ludgerknorps/kimubo/src/kimubo/kimubo.h

/*
   KIMUBO
   KInderMUsikBOx

   Ein minimalistischer WAV/PCM Spieler für Kinder - und mehr.

   (c) 2019 ludgerknorps <56650955+ludgerknorps@users.noreply.github.com>

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
*/
/*






   List of used ressources:

  		#######################################
  			https://github.com/hnauen/Fritzing/blob/master/GF1002_StereoAmplifier/GF1002_StereoAmplifier.fzpz
  			Fritzing part for PAM8403 Amp
  			creative commons license 4.0: Attribution-ShareAlike CC BY-SA
  		#######################################



*/

#ifndef KIMUBO_H
#define KIMUBO_H



#include <Arduino.h>

// Power saving techniques
#include <avr/power.h>
#include <avr/sleep.h>





// ####################################################################################
// ####################################################################################
// ####################################################################################
// ####################################################################################
// ####################################################################################
// ####################################################################################
// ####################################################################################
// ####################################################################################
// ####################################################################################
/*
   Abschnitt DEBUG
*/

// defining debug --> serial output delivers information on internals, timing and cpu load may be a little of compared to non-debug-mode
//	#define debug


// ####################################################################################
// ####################################################################################
// ####################################################################################
// ####################################################################################
// ####################################################################################
// ####################################################################################
// ####################################################################################
// ####################################################################################
// ####################################################################################
/*
   Abschnitt MESSAGES
*/
// define messages as byte arrays in progmem
// see kimubo_090_messages.ino for description

const byte message_readAll[] PROGMEM = { 0, 1, 2, 3, 4, 5, 6, 7, 8, 9, 10, 11 };
const byte message_greeting[] PROGMEM = { 254 };


const byte message_loudness_off[] PROGMEM = { 20 };
const byte message_loudness_on[]  PROGMEM = { 21 };
const byte message_greeting_off[] PROGMEM = { 22 };
const byte message_greeting_on[]  PROGMEM = { 23 };
const byte message_autoplay_off[] PROGMEM = { 24 };
const byte message_autoplay_on[]  PROGMEM = { 25 };


// ####################################################################################
// ####################################################################################
// ####################################################################################
// ####################################################################################
// ####################################################################################
// ####################################################################################
// ####################################################################################
// ####################################################################################
// ####################################################################################
/*
  Abschnitt Main
*/

// tbd later!
//~ // for seeking, i.e. fast forward or backward in a track
//~ //        In order to do that we play a short part of the track,
//~ //        then hop to a position a little further, play again, hop again, etc.
//~ //        There are two relevant user-defined constants:
//~ //          a) SEEK_SPEEDUP       how fast shall seeking be (in times of normal play speed)
//~ //          b) SEEK_DURATION_PLAYING  how much of a track shall be played between hops (in milliseconds)
//~ #define SEEK_SPEEDUP      10
//~ #define SEEK_DURATION_PLAYING 10
//~ //        From those user-defined constants we can derive some internally relevant auto-constants:
//~ //          c) SEEK_INTERVAL_LENGTH   how long is a one seek interval in total (playing + hopping)
//~ //          d) SEEK_INTERVAL_HOP_FWD  how far do we hop forward before playing again
//~ //          e) SEEK_INTERVAL_HOP_BWD  how far do we hop backward before playing again
//~ #define SEEK_INTERVAL_LENGTH  (1000/SEEK_SPEEDUP)
//~ #define SEEK_INTERVAL_HOP_FWD (SEEK_INTERVAL_LENGTH-SEEK_DURATION_PLAYING)
//~ #define SEEK_INTERVAL_HOP_BWD (SEEK_INTERVAL_LENGTH+SEEK_DURATION_PLAYING)

// tbd later!
//~ // for powersaving there is one relevant user-defined constant:
//~ //          a) POWERSAVE_AFTER      after which time (in milliseconds) shall device enter low-power-state
//~ //                        coming from idle, the low-power-state is recoverable,
//~ //                        i.e. we can return to idle on e.g. keypress
//~ #define POWERSAVE_AFTER     3000000
//~ //        From this user-defined constant we can derive some internally relevant auto-constants:
//~ //          b) POWERSAVE_AFTER_PAUSE  after which time in pause-state shall device enter low-power-state
//~ //                        (in times of POWERSAVE_AFTER, not milliseconds!)
//~ //                        coming from pause, the low-power-state is recoverable,
//~ //                        i.e. we can return to pause on e.g. keypress BUT NOT by just turning
//~ //                        the volume up again, thus do not choose a too small value here!
//~ #define POWERSAVE_AFTER_PAUSE (60*POWERSAVE_AFTER)



// if playing stopped, go to powersave mode after configurable time, iff no new track/playlist selected
// in milliseconds
// default is 30minutes aka 900000L
#define POWERSAVE_IF_STOP_AFTER		900000L

// ####################################################################################
// ####################################################################################
// ####################################################################################
// ####################################################################################
// ####################################################################################
// ####################################################################################
// ####################################################################################
// ####################################################################################
// ####################################################################################
/*
  Abschnitt UBat
*/

// the voltage where kimubo shall not startup and shall automatically shut down.
// - in future TBD! - we differentiate between batteries and accumulators.
// for that we will introduce a switch/jumper/... in the back of the KIMUBO - only to be set by parents.
// batteries shall be discharged as much as possible, i.e. down to 0V (ideally)
// accus shall be only discharged down to their limit of about 1000mV in order to increase their life expectancy
// all voltages are given in mV!
#define UBAT_ABSOLUTE_MINIMUM_VOLTAGE_BAT		0
#define UBAT_ABSOLUTE_MINIMUM_VOLTAGE_ACCU		4000







// ####################################################################################
// ####################################################################################
// ####################################################################################
// ####################################################################################
// ####################################################################################
// ####################################################################################
// ####################################################################################
// ####################################################################################
// ####################################################################################
/*
   Abschnitt PCM player
*/

// ++++++++++++++++++++++++++++++++++++++++++++++++++++++++++++++++++++++++++++++++++++
// ++++++++++++++++++++++++++++++++++++++++++++++++++++++++++++++++++++++++++++++++++++
// ++++++++++++++++++++++++++++++++++++++++++++++++++++++++++++++++++++++++++++++++++++
// Pins
// pins are Arduino pin nr.
#define AUDIO_PIN_OUT_HIGH		9
#define AUDIO_PIN_OUT_LOW		10

#define AUDIO_PIN_LOUDNESS  	2


// ####################################################################################
// ####################################################################################
// ####################################################################################
// ####################################################################################
// ####################################################################################
// ####################################################################################
// ####################################################################################
// ####################################################################################
// ####################################################################################
/*
   Abschnitt EEPROM
*/



/* EEPROM Data Layout:
    EEPROM_BASE_ADDR
   	+ 0 Bytes = four Byte (type long) for a chip specific compensation value for accurate VCC measurements

   	+ 4 Bytes = one Byte type byte with ragng (1 ..9) for the last playlist that was played

  		+ 1 Bytes = one Byte type byte for the last track that was played in playlist 1
 		+ 1 Bytes = one Byte type byte for the last track that was played in playlist 2
  		+ 1 Bytes = one Byte type byte for the last track that was played in playlist 3
  		+ 1 Bytes = one Byte type byte for the last track that was played in playlist 4
 		+ 1 Bytes = one Byte type byte for the last track that was played in playlist 5
  		+ 1 Bytes = one Byte type byte for the last track that was played in playlist 6
  		+ 1 Bytes = one Byte type byte for the last track that was played in playlist 7
 		+ 1 Bytes = one Byte type byte for the last track that was played in playlist 8
  		+ 1 Bytes = one Byte type byte for the last track that was played in playlist 9

  		+ 1 Bytes = four Bytes type unsigned long for the last position in last track that was played in playlist 1
 		+ 4 Bytes = four Bytes type unsigned long for the last position in last track that was played in playlist 2
  		+ 4 Bytes = four Bytes type unsigned long for the last position in last track that was played in playlist 3
  		+ 4 Bytes = four Bytes type unsigned long for the last position in last track that was played in playlist 4
 		+ 4 Bytes = four Bytes type unsigned long for the last position in last track that was played in playlist 5
  		+ 4 Bytes = four Bytes type unsigned long for the last position in last track that was played in playlist 6
  		+ 4 Bytes = four Bytes type unsigned long for the last position in last track that was played in playlist 7
 		+ 4 Bytes = four Bytes type unsigned long for the last position in last track that was played in playlist 8
  		+ 4 Bytes = four Bytes type unsigned long for the last position in last track that was played in playlist 9

  		in sum : 50 byte
*/
static const byte EEPROM_BASE_ADDR      		= 	0	; // this one should not be used directly in code, instead use specific addresses form below
// can be set to any value between 0 and "real_eeprom_size" - all bytes used (currently 50)
// therefore for ATMEGA328P with 1024byte EEPROM: between 0 .. 973
// BEWARE:
// we have 1024 bytes of EEPROM on the ATmega328P --> addresses in EEPROM need to be of type "short",
// if we need to address whole EEPROM space.
// As we only need a subset of the address-space we can use byte type instead for addresses,
// iff (!) we limit base address + max needed space (= upper limit of used space)
// to bee 255 or less.

// At first we do not use any wear leveling as the estimated 100000 cycles of EEPROM life amount to
// approx. 100000/10/365 ~= 27 years of use with ten uses per day each day of the year...

static const byte EEPROM_VCCCOMPENSATION_ADDR	=	EEPROM_BASE_ADDR + 0; // four bytes used

static const byte EEPROM_PARENTADMINMODE_SETTINGS_ADDR	= EEPROM_VCCCOMPENSATION_ADDR + 4	; // one byte used

static const byte EEPROM_LAST_PLAYLIST_ADDR		=	EEPROM_PARENTADMINMODE_SETTINGS_ADDR + 1	; // one byte used

// tbd later!
static const byte EEPROM_LAST_TRACK_IN_PLAYLIST[9] = {	EEPROM_LAST_PLAYLIST_ADDR + 1,
                                                        EEPROM_LAST_PLAYLIST_ADDR + 2,
                                                        EEPROM_LAST_PLAYLIST_ADDR + 3,
                                                        EEPROM_LAST_PLAYLIST_ADDR + 4,
                                                        EEPROM_LAST_PLAYLIST_ADDR + 5,
                                                        EEPROM_LAST_PLAYLIST_ADDR + 6,
                                                        EEPROM_LAST_PLAYLIST_ADDR + 7,
                                                        EEPROM_LAST_PLAYLIST_ADDR + 8,
                                                        EEPROM_LAST_PLAYLIST_ADDR + 9
                                                     }; // two bytes used, each

// tbd later!
//~ static const byte EEPROM_LAST_POSITION_IN_TRACK_IN_PLAYLIST[9] = {	EEPROM_LAST_TRACK_IN_PLAYLIST[8] + 1,
//~ EEPROM_LAST_TRACK_IN_PLAYLIST[8] + 6,
//~ EEPROM_LAST_TRACK_IN_PLAYLIST[8] + 10,
//~ EEPROM_LAST_TRACK_IN_PLAYLIST[8] + 14,
//~ EEPROM_LAST_TRACK_IN_PLAYLIST[8] + 18,
//~ EEPROM_LAST_TRACK_IN_PLAYLIST[8] + 22,
//~ EEPROM_LAST_TRACK_IN_PLAYLIST[8] + 26,
//~ EEPROM_LAST_TRACK_IN_PLAYLIST[8] + 30,
//~ EEPROM_LAST_TRACK_IN_PLAYLIST[8] + 34}; // four bytes used, each


// ####################################################################################
// ####################################################################################
// ####################################################################################
// ####################################################################################
// ####################################################################################
// ####################################################################################
// ####################################################################################
// ####################################################################################
// ####################################################################################
/*
   Abschnitt MatrixKeyboard
*/

// ++++++++++++++++++++++++++++++++++++++++++++++++++++++++++++++++++++++++++++++++++++
// ++++++++++++++++++++++++++++++++++++++++++++++++++++++++++++++++++++++++++++++++++++
// ++++++++++++++++++++++++++++++++++++++++++++++++++++++++++++++++++++++++++++++++++++
// 1. Definition KeyScanCodes
static const char KEYSCAN_1      =  '0' ;
static const char KEYSCAN_2      =  '1' ;
static const char KEYSCAN_3      =  '2' ;
static const char KEYSCAN_4      =  '3' ;
static const char KEYSCAN_5      =  '4' ;
static const char KEYSCAN_6      =  '5' ;
static const char KEYSCAN_7      =  '6' ;
static const char KEYSCAN_8      =  '7' ;
static const char KEYSCAN_9      =  '8' ;
static const char KEYSCAN_FFWD   =  'F' ;  // FastForwar / Skip
static const char KEYSCAN_REW    =  'R' ;  // Rewind / Skipback
static const char KEYSCAN_A    	 =  'A' ;  // reserved for future use

// ++++++++++++++++++++++++++++++++++++++++++++++++++++++++++++++++++++++++++++++++++++
// ++++++++++++++++++++++++++++++++++++++++++++++++++++++++++++++++++++++++++++++++++++
// ++++++++++++++++++++++++++++++++++++++++++++++++++++++++++++++++++++++++++++++++++++
// 2. Aus wievielen Reihen und Spalten ist Matrix des Keyboards aufgebaut?

// real hardware no. of rows/colums
static const byte KEYB_ROWS = 4;
static const byte KEYB_COLS = 3;

// ++++++++++++++++++++++++++++++++++++++++++++++++++++++++++++++++++++++++++++++++++++
// ++++++++++++++++++++++++++++++++++++++++++++++++++++++++++++++++++++++++++++++++++++
// ++++++++++++++++++++++++++++++++++++++++++++++++++++++++++++++++++++++++++++++++++++
// 3. Which pin has which matrix-keyboard-row/-column?

// pins are Arduino pin nr.
static const byte KEYB_PIN_COLUMN1  = 7;
static const byte KEYB_PIN_COLUMN2  = 8;
static const byte KEYB_PIN_COLUMN3  = A1;
static const byte KEYB_PIN_ROW1   = 6;  // used as digital pin
static const byte KEYB_PIN_ROW2   = 5;    // used as digital pin
static const byte KEYB_PIN_ROW3   = A2;    // used as digital pin
static const byte KEYB_PIN_ROW4   = A3;    // used as digital pin

// ++++++++++++++++++++++++++++++++++++++++++++++++++++++++++++++++++++++++++++++++++++
// ++++++++++++++++++++++++++++++++++++++++++++++++++++++++++++++++++++++++++++++++++++
// ++++++++++++++++++++++++++++++++++++++++++++++++++++++++++++++++++++++++++++++++++++
// 4. Which Pins are rows, which are columns

// für Power Down müssen alle Reihen-Pins auf High gesezt werden (und danach wieder auf Low)
// dazu müssen wir festlagen, welches die Reihen-Pins und welches die Spalten-Pins sind
static const byte KEYB_RowPins[KEYB_ROWS] = {
  KEYB_PIN_ROW1,
  KEYB_PIN_ROW2,
  KEYB_PIN_ROW3,
  KEYB_PIN_ROW4
}; //connect to the row pinouts of the keypad

static const byte KEYB_ColPins[KEYB_COLS] = {
  KEYB_PIN_COLUMN1,
  KEYB_PIN_COLUMN2,
  KEYB_PIN_COLUMN3
}; //connect to the column pinouts of the keypad


// ++++++++++++++++++++++++++++++++++++++++++++++++++++++++++++++++++++++++++++++++++++
// ++++++++++++++++++++++++++++++++++++++++++++++++++++++++++++++++++++++++++++++++++++
// ++++++++++++++++++++++++++++++++++++++++++++++++++++++++++++++++++++++++++++++++++++
// 5. damit µC zwischendurch in Powerdown gehen kann, müssen alle Keyboard-Inputs (=Reihen, s.o.) mit je einer Diode an diesen Interrupt-Pin angeschlossen sein; dieser weckt dann den µC auf)
// tbd later! static const byte KEYB_PIN_INTERRUPT = 2;

// ++++++++++++++++++++++++++++++++++++++++++++++++++++++++++++++++++++++++++++++++++++
// ++++++++++++++++++++++++++++++++++++++++++++++++++++++++++++++++++++++++++++++++++++
// ++++++++++++++++++++++++++++++++++++++++++++++++++++++++++++++++++++++++++++++++++++
// 6. Die TastaturBelegung selbst = welche Taste ist wo?

static const char KEYB_keyScans[KEYB_ROWS][KEYB_COLS] = {
  { KEYSCAN_1,    KEYSCAN_2,    KEYSCAN_3 },
  { KEYSCAN_4,    KEYSCAN_5,    KEYSCAN_6 },
  { KEYSCAN_7,    KEYSCAN_8,    KEYSCAN_9 },
  { KEYSCAN_REW,  KEYSCAN_FFWD, KEYSCAN_A }
};

// ++++++++++++++++++++++++++++++++++++++++++++++++++++++++++++++++++++++++++++++++++++
// ++++++++++++++++++++++++++++++++++++++++++++++++++++++++++++++++++++++++++++++++++++
// ++++++++++++++++++++++++++++++++++++++++++++++++++++++++++++++++++++++++++++++++++++
// 7. keypad settings

//Set the amount of milliseconds the user will have to hold a button until the HOLD state is triggered. (default = 500)
#define KEYB_HOLD_TIME  500
//Set the amount of milliseconds the keypad will wait until it accepts a new keypress/keyEvent. This is the "time delay" debounce method.  (default = 10)
#define KEYB_DEBOUNCE_TIME  10

// ####################################################################################
// ####################################################################################
// ####################################################################################
// ####################################################################################
// ####################################################################################
// ####################################################################################
// ####################################################################################
// ####################################################################################
// ####################################################################################
/*
   Abschnitt AMP(lifier)
*/

// ++++++++++++++++++++++++++++++++++++++++++++++++++++++++++++++++++++++++++++++++++++
// ++++++++++++++++++++++++++++++++++++++++++++++++++++++++++++++++++++++++++++++++++++
// ++++++++++++++++++++++++++++++++++++++++++++++++++++++++++++++++++++++++++++++++++++
// Pins
// pins are Arduino pin nr.
//~ #define AMP_PIN_LEFTIN 						0 // via resistor-ladder to both PWM outputs #9 and #10 (AUDIO_PIN_OUT_HIGH and AUDIO_PIN_OUT_LOW)
//~ #define AMP_PIN_RIGHTIN 					0 // not used
//~ #define AMP_PIN_GNDIN 						0 // directly connected to GND
//~ #define AMP_PIN_LEFTOUTPLUS 				0 // directly connected to SPEAKER_PIN_PLUS
//~ #define AMP_PIN_LEFTOUTGND 					0 // directly connected to SPEAKER_PIN_MINUS
//~ #define AMP_PIN_RIGHTOUTPLUS 				0 // not used
//~ #define AMP_PIN_LEFTOUTGND 					0 // not used
//~ #define AMP_PIN_POWERPLUS 					0 // directly connected to BATTERY_PIN_PLUS
//~ #define AMP_PIN_POWERGND 					0 // directly connected to GND and BATTERY_PIN_GND
//~ #define AMP_PIN_SWITCHED_PLUS 				0 // directly connected to RAW // this is our power supply!
// used as analog input pin:
// tbd later! #define AMP_PIN_VOL_FEEDBACK					A6
// used as digital output pins:
// tbd later! #define AMP_PIN_MUTE	 						    3

#define AMP_PIN_SUSPEND							  4


// ####################################################################################
// ####################################################################################
// ####################################################################################
// ####################################################################################
// ####################################################################################
// ####################################################################################
// ####################################################################################
// ####################################################################################
// ####################################################################################
/*
   Abschnitt SDCard
*/



// ++++++++++++++++++++++++++++++++++++++++++++++++++++++++++++++++++++++++++++++++++++
// ++++++++++++++++++++++++++++++++++++++++++++++++++++++++++++++++++++++++++++++++++++
// ++++++++++++++++++++++++++++++++++++++++++++++++++++++++++++++++++++++++++++++++++++
// Pins
// pins are Arduino pin nr.
#define SDC_PIN_MOSI	 			11
#define SDC_PIN_MISO				12
#define SDC_PIN_SCK					13
#define SDC_PIN_CS					A0
#define SD_ChipSelectPin A0
//~ #define SDC_PIN_VCC		 		0 // directly connected to RAW
//~ #define SDC_PIN_GND	 			0 // directly connected to GND

// ++++++++++++++++++++++++++++++++++++++++++++++++++++++++++++++++++++++++++++++++++++
// ++++++++++++++++++++++++++++++++++++++++++++++++++++++++++++++++++++++++++++++++++++
// ++++++++++++++++++++++++++++++++++++++++++++++++++++++++++++++++++++++++++++++++++++
// Globals

// define what suffix all PCM/WAV files need to have on the SD-card.
// relevant for "normal" PCM files as well as message-files.
const char SUFFIX_PCM_FILES[5] = ".WAV";

// where on SDcard are all our files stored?
// we use hard-fixed "/", no user-definable variable!

// define how the subdir is named, that holds system-message-pcm-files
// relevant for "normal" PCM files as well as message-files.
// must have leading and trailing '/'
const char SDC_SYSTEM_MESSAGES_DIR[4] = "/M/";

#endif // KIMUBO_H definition
