ludgerknorps/kimubo/src/kimubo/kimubo_020_pcmplayer.ino

/* 
 * KIMUBO
 * KInderMUsikBOx
 * 
 * Ein minimalistischer WAV/PCM Spieler für Kinder - und mehr.
 * 
 * (c) 2019 ludgerknorps <56650955+ludgerknorps@users.noreply.github.com>
 * 
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
 */

//
bool player_setup(){

    player.setupPlayer(AUDIO_PIN_OUT_HIGH, AUDIO_PIN_OUT_LOW);

	// not necessary with change to loudness setting via parent admin mode!
    //pinMode(AUDIO_PIN_LOUDNESS,INPUT_PULLUP);
    //player_is_loudness = true; // default as lkpcm player also starts with volume = 0 (which is loudness), the non-loudness volume would be -3

	if ( readParentAdminSettingLoudness() ) {
		setLoudness();
	} else {
		unsetLoudness();
	}
    
    #if defined (debug)
        Serial.print(F("kimubo INFO software volume is "));
        Serial.println(byte(lkpcm_volume));   
    #endif

    return true; // nothing to do here yet
}

 // ####################################################################################
 // calculates the new track's filename
    void get_new_track_player_filename(const byte curFileNameAsByte, const char curPlaylistName, char* trackFilename){
       char temp_filename[4];
      
       if ( curFileNameAsByte == 255 ){
            strcpy(trackFilename, " "); // default
       } else {
            strcpy(trackFilename, "/ /");
            trackFilename[1] = curPlaylistName; // overwrite
            itoa(curFileNameAsByte, temp_filename, 10); // 10 = convert using decimal system
            strcat(trackFilename, temp_filename);
            strcat(trackFilename, SUFFIX_PCM_FILES);

       }
    } // get_new_track_player_filename()



 

/* =========================================================== */
    void trans_B1_play_playlist_from_first_track(){
        #if defined (debug)
          Serial.print(F("trans_B1_play_playlist_from_first_track "));
          Serial.println(keyb_current_playListKey);   
        #endif

        // goto right dir on sdc
        // open first file e.g. "0.WAV"
        // start playing at begin of file 0

        if ( player_track_number_min[keyb_current_playListKey - '0'] != 255) {
            // there are files in this dir
            
            // remember current playlist
            player_current_playlist_dirname = keyb_current_playListKey;

            // begin with first track 
            player_current_track = player_track_number_min[player_current_playlist_dirname - '0'];
            get_new_track_player_filename(player_current_track, player_current_playlist_dirname, player_current_track_filename);
            player.play(player_current_track_filename);

            // as we just started playback, now is a very good time to spend some CPU-cycles on remembering this track in EEPROM
            remember_current_playlist_and_track_in_eeprom(player_current_track, player_current_playlist_dirname);

            // also: check for battery voltage
            checkBatteryVoltageAndShutdownIfNeccessary();
            
        } else {
            // no file in dir --> do nothing, and just for good measurement: stop player (it should be stopped already!)
            player.stopPlayback();  
            #if defined (debug)
                Serial.print(F("kimubo INFO a playlist without files was selected "));
                Serial.println(player_current_playlist_dirname);   
            #endif
        }; 
        
    }

/* =========================================================== */
    void trans_B2_play_next_track_in_playlist(){

        if ( lkpcm_isStopped ) {
            return; // do nothing, if player is not playing...
        } else{
            player.stopPlayback();
        }
        
        #if defined (debug)
          Serial.print(F("trans_B2_play_next_track_in_playlist "));
          Serial.println(player_current_track);
        #endif

        if ( player_current_track == player_track_number_max[player_current_playlist_dirname - '0'] ) {
            // we had already readched last track 
            #if defined (debug)
                Serial.print(F("kimubo INFO autostop at end of playlist "));
                Serial.println(player_current_track_filename);   
            #endif 
            player.stopPlayback(); 

            // also: check for battery voltage
            checkBatteryVoltageAndShutdownIfNeccessary();
            
            return;
           
        } else {
            player_current_track++;
            get_new_track_player_filename(player_current_track, player_current_playlist_dirname, player_current_track_filename);

            #if defined (debug)
                Serial.print(F("kimubo INFO playing next track "));
                Serial.println(player_current_track_filename);   
            #endif

            player.play(player_current_track_filename);
            
            // as we just started playback, now is a very good time to spend some CPU-cycles on remembering this track in EEPROM
            remember_current_playlist_and_track_in_eeprom(player_current_track, player_current_playlist_dirname);

            // also: check for battery voltage
            checkBatteryVoltageAndShutdownIfNeccessary();
            
            return;
        }
   } // trans_B2_play_next_track_in_playlist


/* =========================================================== */
    void trans_E1_skip_forward(){

        if ( lkpcm_isStopped ) {
            return; // do nothing, if player is not playing...
        }
        
        #if defined (debug)
          Serial.print(F("trans_E1_skip_forward "));  
          Serial.println(player_current_track);
        #endif

        if ( player_current_track == player_track_number_max[player_current_playlist_dirname - '0'] ) {
            // we had already readched last track 
            // as we are skipping on command of user, do nothing, there is no next file 
            #if defined (debug)
                Serial.print(F("kimubo INFO cannot skip to next track, last track reached "));
                Serial.println(player_current_track_filename);   
            #endif 
            return;
           
        } else {
            player_current_track++;
            get_new_track_player_filename(player_current_track, player_current_playlist_dirname, player_current_track_filename);

            #if defined (debug)
                Serial.print(F("kimubo INFO skipping to next track "));
                Serial.println(player_current_track_filename);   
            #endif

            player.play(player_current_track_filename);

            // as we just started playback, now is a very good time to spend some CPU-cycles on remembering this track in EEPROM
            remember_current_playlist_and_track_in_eeprom(player_current_track, player_current_playlist_dirname);

            // also: check for battery voltage
            checkBatteryVoltageAndShutdownIfNeccessary();
            
            return;
        }
   } // trans_E1_skip_forward


/* =========================================================== */
    void trans_E2_skip_backward(){

        if ( lkpcm_isStopped ) {
            return; // do nothing, if player is not playing...
        }
        
        #if defined (debug)
          Serial.print(F("trans_E2_skip_backward ")); 
          Serial.println(player_current_track);
        #endif

        if ( player_current_track == player_track_number_min[player_current_playlist_dirname - '0'] ) {
            // we had already readched first track 
            // as we are skipping back on command of user, just start from begin of file again
            #if defined (debug)
                Serial.print(F("kimubo INFO cannot skip to previous track, first track reached and is now replayed"));
                Serial.println(player_current_track_filename);   
            #endif
            player.play(player_current_track_filename);

            // as we just started playback, now is a very good time to spend some CPU-cycles on remembering this track in EEPROM
            remember_current_playlist_and_track_in_eeprom(player_current_track, player_current_playlist_dirname);
            // actually in this cse this hould not write anything to the EEPROM, as the same track is played again thus the same values would need to be written an as we use EEPROM.update() this does not really trigger a rewrite.

            // also: check for battery voltage
            checkBatteryVoltageAndShutdownIfNeccessary();
            
            return;
           
        } else {
            //  if current file is playing less then x ms then skip to previous file
            if ( lkpcm_isAtBeginOfFile ) {
                player_current_track--;
                get_new_track_player_filename(player_current_track, player_current_playlist_dirname, player_current_track_filename);
    
                #if defined (debug)
                    Serial.print(F("kimubo INFO skipping to previous track "));
                    Serial.println(player_current_track_filename);   
                #endif
                player.play(player_current_track_filename);

                // as we just started playback, now is a very good time to spend some CPU-cycles on remembering this track in EEPROM
                remember_current_playlist_and_track_in_eeprom(player_current_track, player_current_playlist_dirname);

                // also: check for battery voltage
            	checkBatteryVoltageAndShutdownIfNeccessary();
            
                return;
            } else {
                // we just skip back to begin of current file
                #if defined (debug)
                    Serial.print(F("kimubo INFO skipping back to begin of current track"));
                    Serial.println(player_current_track_filename);   
                #endif
                player.play(player_current_track_filename);

                // as we just started playback, now is a very good time to spend some CPU-cycles on remembering this track in EEPROM
                remember_current_playlist_and_track_in_eeprom(player_current_track, player_current_playlist_dirname);
                // actually in this cse this hould not write anything to the EEPROM, as the same track is played again thus the same values would need to be written an as we use EEPROM.update() this does not really trigger a rewrite.

                // also: check for battery voltage
            	checkBatteryVoltageAndShutdownIfNeccessary();
                
                return;
            }
        }
   }


/* =========================================================== */
    void setLoudness(){

        // loundness toggles between normal volume and reduced volume.
        // volume is thereby set via player.volume() function
        if ( lkpcm_volume != 0 ) {
            // it was not loudness and now shall be
            //player_is_loudness = true;
            player.setVolume(4); // => lkpcm_volume = 4-4 = 0
            #if defined (debug)
                Serial.print(F("kimubo INFO loudness on "));
                Serial.println(byte(lkpcm_volume));   
            #endif
        }
        
    } // setLoudness()

/* =========================================================== */
    void unsetLoudness(){

        if ( lkpcm_volume == 0 ) {
            // it was loudness and now shall not be
            //player_is_loudness = false;
            player.setVolume(2); // => lkpcm_volume = 2-4 = -2
            #if defined (debug)
                Serial.print(F("kimubo INFO loudness off "));
                Serial.println(byte(lkpcm_volume));   
            #endif
        } 
        
    } // unsetLoudness()


/* =========================================================== */
    void remember_current_playlist_and_track_in_eeprom(const byte trackNr, const byte playlistNr){
        EEPROM.update(EEPROM_LAST_PLAYLIST_ADDR, playlistNr);
        EEPROM.update(EEPROM_LAST_TRACK_IN_PLAYLIST[playlistNr - '0'], trackNr);
    } // remember_current_playlist_and_track_in_eeprom()

/* =========================================================== */
    void play_last_playlist_and_track_from_eeprom(){
      // this function is only called at device startup.
      // thus player_current_playlist_dirname and player_current_track are to be set to 255 (defaults) if not to something else...
      //
      // EEPROM reads to byte==255 if EEPROM cell was never writtenbefore, so this fits.
      
        player_current_playlist_dirname = EEPROM.read(EEPROM_LAST_PLAYLIST_ADDR);
        if ( player_current_playlist_dirname >= KEYSCAN_1 && player_current_playlist_dirname <= KEYSCAN_9 ) {
            player_current_track = EEPROM.read(EEPROM_LAST_TRACK_IN_PLAYLIST[player_current_playlist_dirname - '0']);

            // track number of 255 signals "no track"...
            if (  player_current_track != 255 &&
                  player_current_track >= player_track_number_min[player_current_playlist_dirname - '0'] && 
                  player_current_track <= player_track_number_max[player_current_playlist_dirname - '0'] ){

                get_new_track_player_filename(player_current_track, player_current_playlist_dirname, player_current_track_filename);
                #if defined (debug)
                    Serial.print(F("kimubo INFO autoplaying "));
                    Serial.println(player_current_track_filename);   
                #endif
                
                player.play(player_current_track_filename);
                
                // as we just started playback, now is a very good time to spend some CPU-cycles on remembering this track in EEPROM
                remember_current_playlist_and_track_in_eeprom(player_current_track, player_current_playlist_dirname);
                // actually in this cse this hould not write anything to the EEPROM, as the same track is played again thus the same values would need to be written an as we use EEPROM.update() this does not really trigger a rewrite.

                // also: check for battery voltage
            	checkBatteryVoltageAndShutdownIfNeccessary();
   
            } else {

                // do nothing
                #if defined (debug)
                    Serial.print(F("kimubo INFO autoplaying wanted to play a unsensible track "));
                    Serial.print(player_current_playlist_dirname); 
                    Serial.print(F(" track "));   
                    Serial.println(player_current_track);     
                #endif
            } // if track ok

        } else {

            // do nothing
            #if defined (debug)
                Serial.print(F("kimubo INFO autoplaying wanted to play a unsensible playlist "));
                Serial.print((byte) player_current_playlist_dirname);
                Serial.print(F(" : "));
                Serial.println(player_current_playlist_dirname);   
            #endif
             
        }
        
        
    } // play_last_playlist_and_track_from_eeprom()

        


// EOF
