ludgerknorps/kimubo/src/kimubo/kimubo_050_parent_admin_mode.ino

/* 
 * KIMUBO
 * KInderMUsikBOx
 * 
 * Ein minimalistischer WAV/PCM Spieler für Kinder - und mehr.
 * 
 * (c) 2019 ludgerknorps <56650955+ludgerknorps@users.noreply.github.com>
 * 
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
 */

	// global variable to hold the parent settings from/to EEPROM
	// bit 0 == 	loudness == 		( gv_parentAdminModeSettings >> 0) & 1 )
	// bit 1 == 	greeting == 		( gv_parentAdminModeSettings >> 1) & 1 )
	// bit 2 == 	autoplay == 		( gv_parentAdminModeSettings >> 2) & 1 )
	byte gv_parentAdminModeSettings;


	/* =========================================================== */
	bool setupParentAdminSettingsFromEEPROM(){
		
		// STEP 0: Read AdminSettings from EEPROM 
		EEPROM.get(EEPROM_PARENTADMINMODE_SETTINGS_ADDR, gv_parentAdminModeSettings); // this is one byte

		#if defined (debug)
            Serial.print(F("kimubo INFO PAM byte "));
            Serial.println(byte(gv_parentAdminModeSettings));   
        #endif
		
	}
	
  	/* =========================================================== */
	bool checkForParentAdminModeAtDeviceStartup(){
		// we enter parent admin mode by having two keys pressed at startup --> getkey*S*()
		delay(50); // possibly not necessary but to be safe for debouncing...
		keypad.getKeys();
		
		return ( 	(keypad.countPressed() == 2) && 
					(keypad.findInList((char)KEYSCAN_1) != -1) && 
					(keypad.findInList((char)KEYSCAN_4) != -1) 
				);
	}

	/* =========================================================== */
	void parentAdminModeReadVcc(){
		batteryVoltageAsMessageToParents();
	}

	/* =========================================================== */
	// this function blocks until PowerOff-PowerOn Reset!!
	void parentAdminModeLoop(){

		/*
		 * ok, what can the (parent) user do in this parent admin mode?
		 * 
		 * a) press key1 (upper left) --> device tells the current battery voltage to user
		 * 
		 * b)
		 *    press key 2 (upper middle) repeatedly --> toggle loudness:
		 * 		each press: loudness toggles and device tells new setting
		 * 		
		 * 		loudness has the following states: OFF, ON
		 * 		
		 * c) TBD LATER! 
		 *    press key 3 (upper right) repeatedly --> toggle sleepTimer:
		 * 		first press: device tells the current sleepTimer setting to user
		 * 		each following press: sleepTimer toggles and device tells new setting
		 * 		
		 * 		sleepTimer has the following states: OFF, 15min, 30min
		 * 		
		 * d)
		 *    press key 4 (middle left) repeatedly --> toggle Greeting:
		 * 		each press: Greeting toggles and device tells new setting
		 * 		
		 * 		Greeting has the following states: OFF, ON-FIXED, ON-RANDOM
		 * 		where 	ON-FIXED will always play file 254.WAV and 
		 * 				ON-RANDOM plays (randomly) one of 245.WAV .. 254.WAV
		 * 		ON-RANDOM will be implemented later!
		 * 		
		 * e)
		 *    press key 5 (middle middle) repeatedly --> toggle Autoplay:
		 * 		each press: Autoplay toggles and device tells new setting
		 * 		
		 * 		Autoplay has the following states: OFF, ON
		 * 		
		 * 	
		 * 		
		 * other than in normal playback mode the actions are carried out at pressing the key (compared to releasing a key)
		 */

		char c;

		keyb_waitForAllKeysToBeReleased();

		// we only leave parent admin mode by power-off-on-reset
		while (1){

			c = keypad.waitForKey();
		
			if ( c == KEYSCAN_1 ) {

				#if defined (debug)
		            Serial.println(F("kimubo INFO PAM 1 ")); 
		        #endif
				parentAdminModeReadVcc();
				
			} else if ( c == KEYSCAN_2 ) {
				
				// toggle loudness
				if ( readParentAdminSettingLoudness() ) {
					clrParentAdminSettingLoudness();
					unsetLoudness();
					playMessage(message_loudness_off, sizeof(message_loudness_off));
				} else {
					setParentAdminSettingLoudness();
					setLoudness();
					playMessage(message_loudness_on, sizeof(message_loudness_on));
				}
				#if defined (debug)
		            Serial.println(F("kimubo INFO PAM 2 ")); 
		            Serial.print(F("kimubo INFO PAM byte "));
		            Serial.println(byte(gv_parentAdminModeSettings));   
		        #endif
		        // write to eeprom
				EEPROM.put(EEPROM_PARENTADMINMODE_SETTINGS_ADDR, gv_parentAdminModeSettings);
			
			} else if ( c == KEYSCAN_4 ) {
				
				// toggle greeting
				if ( readParentAdminSettingGreeting() ) {
					clrParentAdminSettingGreeting();
					playMessage(message_greeting_off, sizeof(message_greeting_off));
				} else {
					setParentAdminSettingGreeting();
					playMessage(message_greeting_on, sizeof(message_greeting_on));
				}
				#if defined (debug)
		            Serial.println(F("kimubo INFO PAM 4 ")); 
		            Serial.print(F("kimubo INFO PAM byte "));
		            Serial.println(byte(gv_parentAdminModeSettings));  
		        #endif
				// write to eeprom
				EEPROM.put(EEPROM_PARENTADMINMODE_SETTINGS_ADDR, gv_parentAdminModeSettings);
			
			} else if ( c == KEYSCAN_5 ) {

				// toggle greeting
				if ( readParentAdminSettingAutoplay() ) {
					clrParentAdminSettingAutoplay();
					playMessage(message_autoplay_off, sizeof(message_autoplay_off));
				} else {
					setParentAdminSettingAutoplay();
					playMessage(message_autoplay_on, sizeof(message_autoplay_on));
				}
				#if defined (debug)
		            Serial.println(F("kimubo INFO PAM 5 ")); 
		            Serial.print(F("kimubo INFO PAM byte "));
		            Serial.println(byte(gv_parentAdminModeSettings));  
		        #endif
		        // write to eeprom
				EEPROM.put(EEPROM_PARENTADMINMODE_SETTINGS_ADDR, gv_parentAdminModeSettings);
			}

			keyb_waitForAllKeysToBeReleased();
			
		}
		
	} // parentAdminModeLoop()
