ludgerknorps/kimubo/src/kimubo/kimubo_060_ubat.ino

/* 
 * KIMUBO
 * KInderMUsikBOx
 * 
 * Ein minimalistischer WAV/PCM Spieler für Kinder - und mehr.
 * 
 * (c) 2019 ludgerknorps <56650955+ludgerknorps@users.noreply.github.com>
 * 
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
 */

 

// ####################################################################################
// ####################################################################################
// ####################################################################################
// ####################################################################################
// ####################################################################################
// ####################################################################################
// ####################################################################################
// ####################################################################################
// ####################################################################################
/* 
 * Abschnitt UBat measurement
 */
 
	// ++++++++++++++++++++++++++++++++++++++++++++++++++++++++++++++++++++++++++++++++++++
	// ++++++++++++++++++++++++++++++++++++++++++++++++++++++++++++++++++++++++++++++++++++
	// ++++++++++++++++++++++++++++++++++++++++++++++++++++++++++++++++++++++++++++++++++++
	// Read 1.1V reference against AVcc
	// taken from http://provideyourown.com/2012/secret-arduino-voltmeter-measure-battery-voltage/
	// 
	// blocking does not matter to us because we measure between tracks -->  some ms don't matter at all :-)
	

		/* =========================================================== */
		// called once at device startup
		void setupReadVcc(){
			
			// STEP 0: Read gv_smUBat_ChipsVccCompensationValue from EEPROM (see below for explanation on that value!)
			EEPROM.get(EEPROM_VCCCOMPENSATION_ADDR, gv_UBat_ChipsVccCompensationValue); // this is a long, i.e. 4 bytes!
			
			#if defined (debug)
				Serial.print(F("gv_UBat_ChipsVccCompensationValue from EEPROM: "));
				Serial.println(gv_UBat_ChipsVccCompensationValue);
			#endif
			
			if ( gv_UBat_ChipsVccCompensationValue == -1 ) {
				// nothing was stored in EEPROM --> default to assumption that Vcc is exactely 5.00V
				// see http://provideyourown.com/2012/secret-arduino-voltmeter-measure-battery-voltage/ for details.
				#if defined (debug)
					Serial.println(F("WARNING no ChipsVccCompensationValue found in EEPROM, defaulting to assumption that Vcc is exactely 5.00V"));
				#endif
				gv_UBat_ChipsVccCompensationValue = 1125300L; // Calculate Vcc (in mV); 1125300 = 1.1*1023*1000 which means exactly 5V
			}
			
		} // setupReadVcc()
		
		/* =========================================================== */
		// called at device startup + before each track + after last track + after waking up from sleep
		void readVcc() {
			
			// STEP 1: save current ADMUX settings to temporary variable
			byte uBat_OldADMUX = ADMUX;
			
			// STEP 2: set the reference to Vcc and the measurement to the internal 1.1V reference
			// ATMEGA328P, others see http://provideyourown.com/2012/secret-arduino-voltmeter-measure-battery-voltage/
			ADMUX = _BV(REFS0) | _BV(MUX3) | _BV(MUX2) | _BV(MUX1); 
			delay(2); // blocking wait, does not matter as we measure between tracks --> 2ms don't matter at all :-)
			
			// STEP 3: start conversion
			ADCSRA |= _BV(ADSC);
			
			while (bit_is_set(ADCSRA,ADSC)); // bloking measuring
			//  until bit is reset --> conversion finished
			
			// STEP 5: calculate Vcc
			/* 		we know the measured value is     Vcc*(ADC-measure)/1023
			 * 		AND we know that we can expect ADC-measure to be 1.1V = 1100mV
			 * 		Solve that for Vcc to get         Vcc = 1100 * 1023 / ADC-measure
			 * 		Now, ADC measure is NOT REALLY 1100mV on each individual arduino chip
			 * 		therefore, we have to use a compensation value taken from EEPROM (which must be first stored there beforehand!)
			 * 		gv_smUBat_ChipsVccCompensationValue: this one is individual for each chip!
			 * 		(if you don't have an individually measured compensationvalue, then take the generic gv_smUBat_ChipsVccCompensationValue = 1100 * 1023 = 1125300L)
			 * 		
			 * 		In order to measure this value do the following:
			 * 		a) let readVcc() run with default value 1125300L
			 * 		b) measure with multimeter the real Vcc
			 * 		c) calculate gv_smUBat_ChipsVccCompensationValue = 1.1 * Vcc_of_multimeter / Vcc_of_readVcc_function * 1023 * 1000
			 * 		d) write that value gv_smUBat_ChipsVccCompensationValue to EEPROM to the same address you will read it back from at startup
			 * 			use e.g. 
			 */
			byte low  = ADCL; // must read ADCL first - it then locks ADCH  
			byte high = ADCH; // unlocks both
			gv_UBat_in_millivolt = (high<<8) | low; // not yet compensated Vcc (in mV)!
			gv_UBat_in_millivolt = gv_UBat_ChipsVccCompensationValue / gv_UBat_in_millivolt; // now its compensated!
			
			// STEP 6: clean up
			ADMUX = uBat_OldADMUX;	
			
			#if defined (debug)
				Serial.print(F("INFO Vbat is [mV] "));
				Serial.println(gv_UBat_in_millivolt);
			#endif
		
		} // readVcc()


		/* =========================================================== */
		// returns true if measured Vcc is below UBAT_ABSOLUTE_MINIMUM_VOLTAGE_ACCU or in future UBAT_ABSOLUTE_MINIMUM_VOLTAGE_BAT
		bool isLowBat(){
			return ( gv_UBat_in_millivolt < UBAT_ABSOLUTE_MINIMUM_VOLTAGE_ACCU );
		} // isLowBat()


		/* =========================================================== */
		// function to shutdown the KIMUBO
		void shutDownBecauseOfUndervoltage(){
			#if defined (debug)
				Serial.print(F("ERROR KIMUBO SHUTDOWN BECAUSE OF UNDERVOLTAGE!!! Measured battery voltage is [mV] "));
				Serial.println(gv_UBat_in_millivolt);
				delay(100); // wait for Serial message to finish...
			#endif
			player.stopPlayback(); 
			amp_shutdown();
			
			// set arduino to deep sleep
			// it will only recover via Power-Off-Power-On
			set_sleep_mode(SLEEP_MODE_PWR_DOWN);  
			sleep_enable();  
			sleep_mode();
			// now it sleeps... and draws almost no current...
			
		} // shutDownBecauseOfUndervoltage()

		/* =========================================================== */
		// helper function that wraps the other three functions...
		void checkBatteryVoltageAndShutdownIfNeccessary(){
			readVcc();
			if ( isLowBat() ){
				shutDownBecauseOfUndervoltage();
			}
		} // checkBatteryVoltageAndShutdownIfNeccessary()


		/* =========================================================== */
		// in parent-admin-mode: device reads the current voltage to user (via PCM-files!)
		void batteryVoltageAsMessageToParents(){
			readVcc();

			// from voltage in millivolts to message...
			byte message_VccVoltage[] = { 0, 10, 0, 11}; // default is <Null><Komma><Null><Volt>; "0" values are then changed to correct values...

			// e.g. 4865 mV --> 4		the first digit of Vcc, it is always floored() and not arithmetically rounded.
			message_VccVoltage[0] = ( (int) (gv_UBat_in_millivolt/1000) );
			//message_VccVoltage[0] = 4;
			// e.g. 4865 mV --> 8		the second digit of Vcc, it is rounded. we floor() again as this is much cheaper (in CPU cycles) than foing floating point arithmetic!
			message_VccVoltage[2] = ( (int) ( (gv_UBat_in_millivolt - (message_VccVoltage[0]*1000) ) / 100) );
			//message_VccVoltage[2] = 7;
			
			playMessage(message_VccVoltage, sizeof(message_VccVoltage), false);
			
		} // batteryVoltageAsMessageToParents()
		
		
		
 
// EOF
