ludgerknorps/kimubo/(commit log)

2019-11-28 stash version with SDFAT library.
    We will switch to PetitFS.
2019-12-03 stashed non-wirking version using petitfs and non-library for pcm
2019-12-08 NOT WORKING (probably last version of kimubo with fsm)
    it simply uses too much ram!
    [kimubo.h, kimubo.ino, kimubo_010_globals.ino, kimubo_020_pcmplayer.ino, kimubo_040_sdfet.ino]
2019-12-10 UNTESTED play first track in playlist on key-release also change playlist (first track only)
2019-12-11 NOT FULLY WORKING stashed version with lookup of next track and Skip-Forward
    [kimubo_010_globals.ino, kimubo_020_pcmplayer.ino, kimubo_070_keypad.ino, kimubo_900_setup-function.ino, kimubo_950_loop-function.ino]
2019-12-11 WORKING skip forward works, playlist change works
    [kimubo_020_pcmplayer.ino, kimubo_900_setup-function.ino]
2019-12-11 WORKING skip forward and backward
    including:
    * don't skip forward beyond last track
    * don't skip backward beyond first track
    * skip bakward to begin of current file, if not at begin of file
    * skip backward to previous file, if at begin of file
    * autoplay next file in playlist at end of file
    * autostop at end of playlist
    cool
    [kimubo_010_globals.ino, kimubo_020_pcmplayer.ino, kimubo_070_keypad.ino, kimubo_950_loop-function.ino]
2019-12-12 WORKING added a hardware mute pin
2019-12-12 WORKING added loudness via switch
    (if corresponding pin = low --> volume is reduced in software)
    not via keyboard! thus removed keypad-loudness-things
2019-12-15 WORKING improved auto play next track
2019-12-26 new feature: autoplay
    at begin of each track the track + playlist are stored in EEPROM
    at startup these values are read from EEPROM and play is automatically started at this track.
    autoplay can be enabled/disabled by #debug in config
2020-01-05 enhance battery life with power saving techniques
2020-01-05 Battery voltage is measured at startup, each track begin, after last track. If voltage is too low, then auto-shutdown of KIMUBO
    [kimubo_010_globals.ino, kimubo_020_pcmplayer.ino, kimubo_060_ubat.ino, kimubo_900_setup-function.ino]
2020-01-06 helper program to write device-specific compensation value into EEPROM
2020-01-11 introduce new parent-admin-mode at device-startup
    iff certain key is pressed while device is powered on, then device goes to special admin mode for parents.
    In this parents can set certain device-options:
    a) read battery voltage
    b) set loudness (instead of with jumper)
    c) set sleep timer
    in this commit, only a dummy is played if parent-admin-mode is entered.
    It is activated by keeping key 0 pressed during startup.
2020-01-13 parent admin mode with own loop
    * moved decision to enter mode at startup from loop() to setup()
    it really belongs there
    * keypad-event-handler separated for normal playback mode and parent admin mode
    * unnecessary debug keypad-event handler removed
    * unnecessary 050_volpod.ino removed we no longer plan to need that)
    * cleanup of 010_globals.ino
    [kimubo_010_globals.ino, kimubo_070_keypad.ino, kimubo_900_setup-function.ino, kimubo_950_loop-function.ino]
